demestor/robot_platform/images/robot_back.jpg

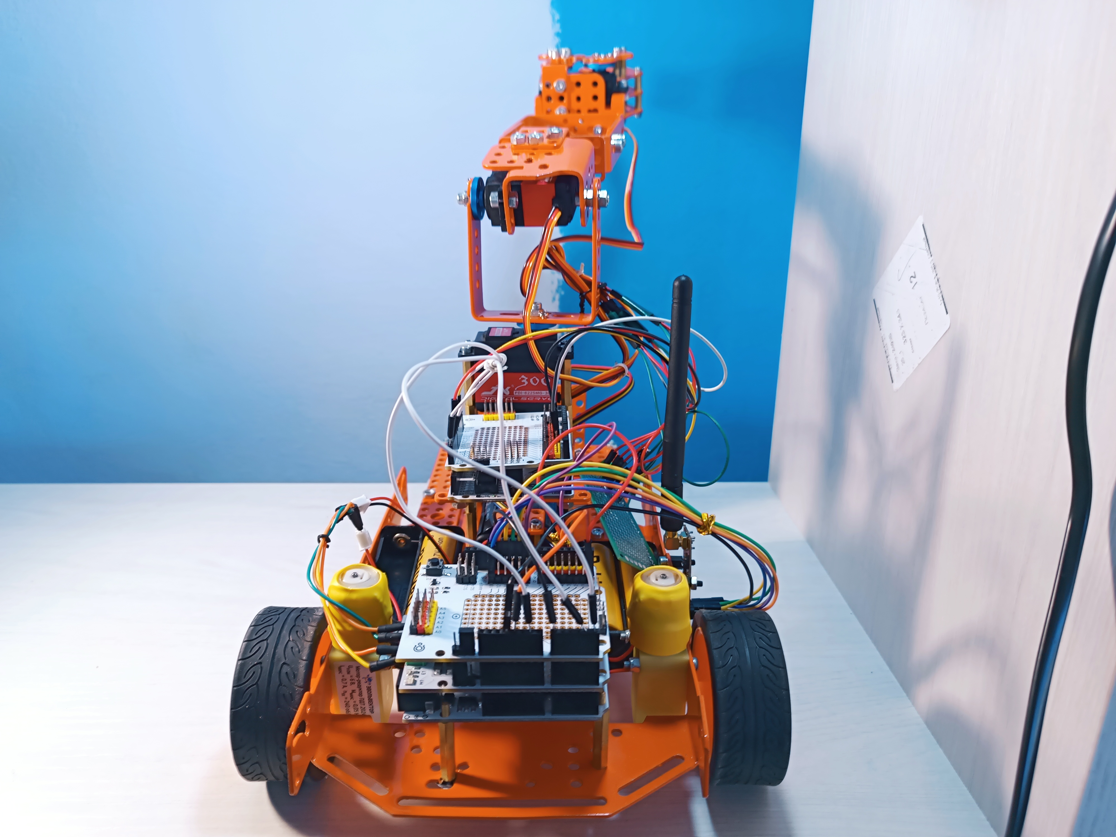
images/robot_back.jpg
