demestor/robot_platform/Сопроводительная записка.docx

Образец оформления титульного листа пояснительной записки

Открытый республиканский конкурс

«Проектный прорыв: моделирование, конструирование и приборостроение»

Направление: Образовательный проект

РАЗРАБОТКА МОБИЛЬНОЙ РОБОПЛАТФОРМЫ С МАНИПУЛЯТОРОМ И СИСТЕМОЙ ДИСТАНЦИОННОГО УПРАВЛЕНИЯ

Автор: Дерябин Игорь Андреевич, Якунин Кирилл Аркадьевич

обучающаяся кружка «Робототехника»

ГБУДО «ЦТТ – «КВАНТОРИУМ»»

Научный руководитель:

Душа Михаил Валерьевич,

педагог дополнительного образования

ГБУДО «ЦТТ – «КВАНТОРИУМ»»

г. Донецк, 2026 г.

# ВВЕДЕНИЕ

В настоящее время на рынке представлено большое количество готовых робототехнических наборов, однако, чаще всего, их функционал ограничен заранее выбранной направленностью, а возможности модификации ограничены. Это не позволяет в полной мере изучить различные направления робототехники детально, получить глубокое понимание основ.

В условиях активного развития инженерного образования в Донецкой Народной Республике существует потребность в открытых, масштабируемых и бюджетных учебных платформах, которые позволят детально изучить основные робототехнические разделы, самостоятельно дорабатывать архитектуру устройства и модифицировать поведение программным кодом.

Цель работы: разработать мобильную робоплатформу с открытым исходным кодом, широкими способами модификации, реализующую возможность изучения основных разделов робототехники: электротехники, программирования, задач кинематики, способов передачи информации.

# 1. РАЗРАБОТКА ПРОЕКТА

Одним из самых увлекательных направлений современного технического творчества является разработка мобильных робоплатформ с манипуляторами. Такие устройства позволяют одновременно изучать механику, электронику, программирование микроконтроллеров, беспроводную связь и системы автоматического управления, репрезентируя процесс промышленного производства или научно-исследовательской разработки. Робоплатформы используются в образовании, на соревнованиях, в поисково-спасательных работах и даже в простых автоматизированных задачах. В настоящее время на рынке и онлайн магазинах представлено большое количество готовых наборов по сборке подобных платформ. Для определения особенностей и характеристик разрабатываемого проекта, был проведен анализ доступной информации и существующих аналогов.

## 1.1 Обзор аналогов

Представленные на рынке робототехнические платформы, программируемые при помощи микроконтроллеров, можно разделить на три основных типа конструкций.

Стационарные манипуляторы. Представляют собой неподвижную платформу со средствами управления и несколькими сервоприводами, установленных в характерный для манипуляторов корпус. Решения позволяют изучить кинематику манипуляторов, изучить ручное и автоматическое управление сервоприводами для решения различных задач, однако ограниченная мобильность и, зачастую, отсутствие возможности доработки платформы ограничивают перечень изучаемых направлений в робототехнике

Мобильные платформы без манипуляторов. Оснащенные драйверами управления и несколькими двигателями в корпусе, данные решения позволяют изучить больший перечень типичных робототехнических задач и направлений, таких перемещение в пространстве, навигация, изменение поведения основываясь на данных с датчиков. Однако отсутствие подготовленной архитектуры не позволяет добавить манипулятор, что не позволяет в полной мере изучить кинематику в робототехнике

Мобильные платформы с манипуляторами. Решения, дающее наиболее близкое понимание основных робототехнических задач. Поскольку разрабатываемый проект ориентируется на данный тип конструкции, был проведен анализ наиболее близких аналогов. Результат анализа приведен в Таблице 1.1.

Таблица 1.1 – сравнительный анализ аналогов проекта

Свойство | Робототехнический набор
| Keystudio 4DOF Mechanical Robot Arm Car | Xiao-r TH Robot Car | РОББО Робоплатформа
Тип управления | Джойстик, приложение через Bluetooth | Приложение через Wi-Fi | Приложение через Bluetooth
Манипулятор | 3 степени свободы | 4 степени свободы | Простой захват
Архитектура | Плата контроллер, плата расширения | Плата контроллер, плата расширения | Модульная
Режимы работы | Ручной, автономный, на основе датчиков | Ручной, автономный, на основе датчиков и камеры | Ручной, автономный, на основе датчиков
Дальность связи | 5–10 м | 30-50 м | до 10 м
Основные недостатки для обучения | Короткая дальность, закрытые примеры кода, ограниченные возможности модификации | Сложная конструкция, ограниченные возможности модификации | Нет манипулятора, привязка к фирменному ПО

Анализ показал, что большинство готовых решений имеют общие ограничения:

Ограниченные возможности управления. Наборы оснащены заранее предусмотренными в конструкции датчиками и модулями связи, что не позволяет использовать собственные способы коммуникации с робоплатформой.

Ограниченные возможности модификации. Отсутствие модульной структуры или структура, поддерживающая ограниченный набор компонентов, значительно ограничивают возможности изучения и доработки платформы, снижают функционал.

Использование одного микроконтроллера. Использование одной управляющей платы упрощает конструкцию, однако лишает робоплатформу модульности и расширяемости, а также лишает возможности изучение проводной связи между микроконтроллерами.

Для решения перечисленных проблем было принято решение разработать оригинальную открытую мобильную робоплатформу с манипулятором под управлением двух микроконтроллеров и управлением через радиомодуль при помощи собственного пульта дистанционного управления и автономным режимом на основе информации с датчиков.

## 1.2 Анализ использованных решений

При разработке робоплатформы был принят ряд технических решений, поспособствовавших улучшению модульности, энергопотребления и связи. Основной особенностью является использование двух микроконтроллеров для управления платформой. Основной микроконтроллер отвечает за обработку радиосигнала и сигнала ультразвукового дальномера, управление двигателями постоянного тока. Второй микроконтроллер отвечает за управление сервомоторами манипулятора. Такое разделение позволяет инкапсулировать разные задачи, упрощая понимание работы отдельных подвижных частей платформы; увеличивает число дополнительных подключаемых датчиков и модулей; позволяет изучить основы передачи информации между микроконтроллерами при помощи шины данных.

Помимо разделения управляющей логики, источник питания также был разделен – отдельные аккумуляторы подключены к каждому микроконтроллеру и питают только модули их зоны функционирования. Такое решение позволит улучшить стабильность работы серводвигателей и двигателей постоянного тока, для которых правильная организация питания критична. Также улучшается модульность конструкции – каждая плата может использоваться как автономный модуль с собственной программой. Разделение позволяет экономить электрический заряд аккумуляторов, потребляя заряд только для используемого модуля.

Следующим важным аспектом является использование модуля радиосвязи вместо модуля приема-передачи по протоколу Bluetooth. Преимуществами радиомодуля является высокая дальность работы, низкое энергопотребление и простота интеграции и настройки. Однако, модульная структура робоплатформы позволяет добавить модуль Bluetooth для управление через мобильные устройства или пульты дистанционного управления на основе этого модуля.

## 1.3 Описание конструкции

Робоплатформа представляет собой модульную систему из двух микроконтроллеров, связанных через интерфейс связи I2C, обрабатывающую сигналы управления при помощи радиомодуля приема-передатчика NRF24L01. На рисунке 1.1 представлена блок-схема работы робоплатформы.

Рисунок 1.1 – блок-схема работы робоплатформы

Микроконтроллер пульта дистанционного управления обрабатывает сигналы элементов управления (кнопки, двухосевой джойстик), формирует и отправляет пакет данных, содержащий указания для робоплатформы, при помощи радиомодуля NRF24L01. Второй радиомодуль на платформе принимает пакет, основной микроконтроллер обрабатывает его и запускает двигатели или ультразвуковой дальномер. Если в пакете содержались данные от двухосевого джойстика, основной микроконтроллер передает их на микроконтроллер манипулятора через интерфейс I2C. Второй микроконтроллер обрабатывает поученные данные и меняет положенение серводвигателей.

На Рисунке 1.2 представлена диаграмма подключения для пульта дистанционного управления.

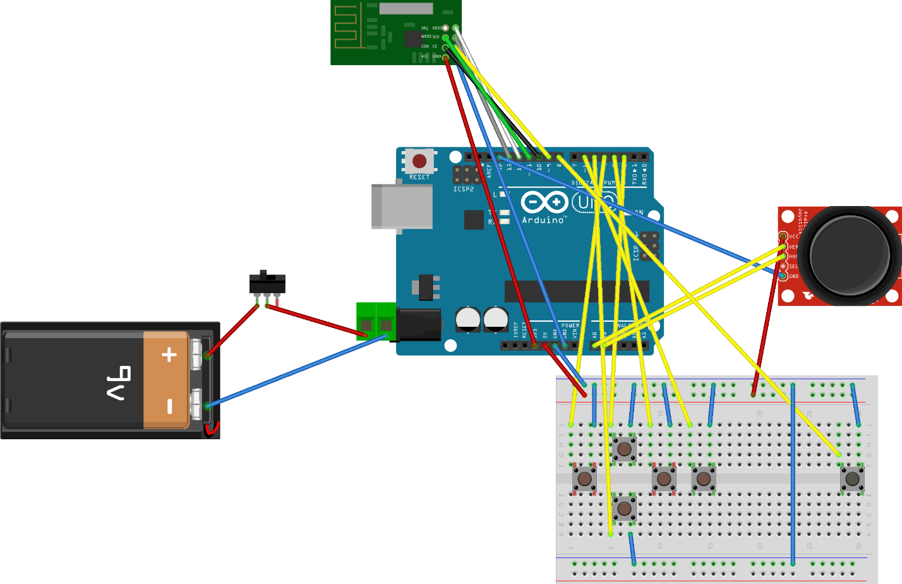
[picture p2: figure]

Рисунок 1.2 - Диаграмма подключения для пульта дистанционного управления.

4 крестообразно расположенные кнопки отвечают за движение робоплатформы. Кнопка справа, подключенная к пину 6, изменяет режим работы – ручное управление или случайное движение на основе ультразвукового дальномера. Крайняя правая кнопка отвечает за закрытие захватного устройства.

Наклон двухосевого джойстика отвечает за изменение двух углов сервоприводов манипулятора. Так как в корпусе пульта модуль джойстика повернут на 90 градусов по часовой стрелке относительно своего основного положения, оси X и Y поменяны местами.

Питание пульта организованно от батареи кроны 9В, подключенную через клеммник с переходом на разъем на разъем jack 2.2 мм. Между положительным полюсом кроны и клеммником припаян ползунковый переключатель, для отключения пульта в неактивном состоянии.

В таблице 1.2 приведен полный перечень электронных компонентов для пульта дистанционного управления.

Таблица 1.2 - перечень электронных компонентов для пульта дистанционного управления

Название | Количество | Характеристики
Плата Iskra Uno | 1 | Микроконтроллер: ATmega328P; Архитектура: AVR (8 бит); Тактовая частота: 16 МГц; Flash-память: 32 КБ; Напряжение логических уровней: 5 В; Входное напряжение через USB: 5 В; Входное напряжение через DC-разъём или пин Vin: 7–12 В; Размеры платы: 69×53 мм
Радиомодуль приема-передатчик NRF24L01 | 1 | Частота: 2,4 ГГц–2,5 ГГц; Рабочее напряжение: не более 3 ~ 3,6 В; Поддержка до шести каналов приема данных; Дальность передачи: до 1000 м
Модуль двухосевого джойстика HW-504 | 1 | Размер: 26×34 мм; Рабочее напряжение: 3,3–5 В
Батарея крона | 1 | Номинальное напряжение: 9 В
Тактовая кнопка | 6
Ползунковый переключатель | 1
Беспаечная макетная плата | 1
Коннектор с клеммником | 1

На рисунке 1.3 представлена диаграмма подключения для робоплатформы и манипулятора

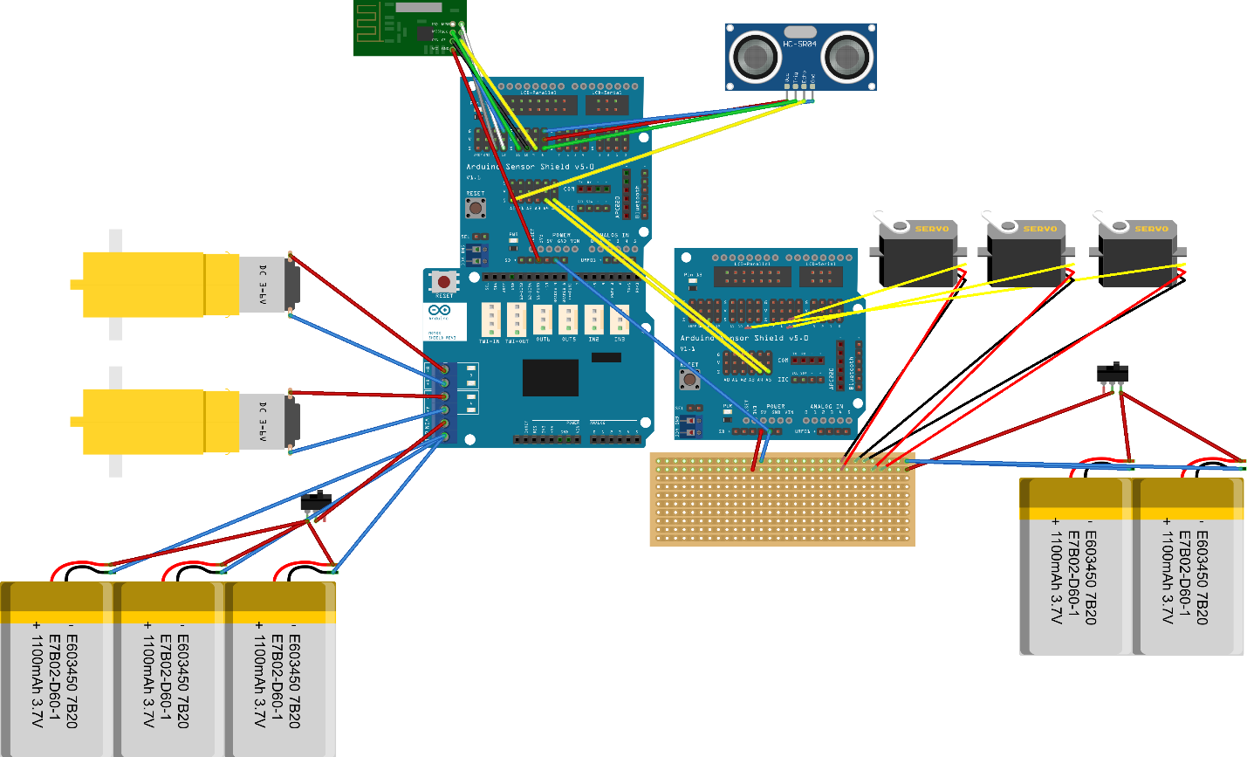
[picture p3: figure]

Рисунок 1.3 - Диаграмма подключения для пульта дистанционного управления.

На схеме обозначены подключения для плат расширения, сами платы подключаются поверх плат с микроконтроллерами.

Управление двигателями осуществляется при помощи платы расширения Motor Shield на базе чипа L298P, моторы подключены к двум каналам платы через клеммники. На третий клеммник платы подключены 3 аккумулятора Li-ion 18650. Между положительными полюсами и клеммником питания припаян ползунковый переключатель, для отключения робоплатформы в неактивном состоянии.

Плата расширения Troyka Shield устанавливается поверх Motor Shield для упрощенного доступа к пинам. К тройным контактам «S-V-G» подключается ультразвуковой дальномер и радиомодуль NRF24L09.

Вторая плата расширения устанавливается поверх второго микроконтроллера, отвечающего за работу сервопривода. Управляющие провода сервомоторов подключены к плате расширения, провода питания выведены и припаяны на перфорированную макетную плату. Между положительными полюсами и клеммником припаян ползунковый переключатель, для отключения манипулятора в неактивном состоянии. Связь между двумя микроконтроллерами по интерфейсу I2C осуществляется через 2 провода А4 и А5.

В таблице 1.3 приведен полный перечень электронных компонентов для робоплатформы и манипулятора.

Таблица 1.3 - перечень электронных компонентов для робоплатформы и манипулятора

Название | Количество | Характеристики
Плата Iskra Uno | 2 | Микроконтроллер: ATmega328P; Архитектура: AVR (8 бит); Тактовая частота: 16 МГц; Flash-память: 32 КБ; Напряжение логических уровней: 5 В; Входное напряжение через USB: 5 В; Входное напряжение через DC-разъём или пин Vin: 7–12 В; Размеры платы: 69×53 мм
Плата расширения Troyka Shield | 2 | Питание подключаемых модулей: 3.3–5 В; Интерфейс I2C: 3 группы контактов
Плата расширения Motor Shield | 1 | Напряжение логической части: 3.3–5 В; Напряжение силовой части в режиме PWR JOIN: 5–12В; Продолжительный ток нагрузки на канал: до 2 А
Радиомодуль приема-передатчик NRF24L01 | 1 | Частота: 2,4 ГГц–2,5 ГГц; Рабочее напряжение: не более 3–3,6 В; Поддержка до шести каналов приема данных; Дальность передачи: до 1000 м
Ультразвуковой дальномер HC-SR04 | 1 | Угол обзора: 15°; Измеряемая дальность: 3–400см; Рабочее напряжение: 5 В
Аккумулятор Rakieta Li-ion 18650 | 5 | Емкость: 12000 мАч; Номинальное напряжение: 3,7 В
Сервомотор Servo PDI-6225MG-300 | 3 | Рабочее напряжение: 4.8–6В; Скорость: 0.21 c/60°; Угол поворота: 300°
Двигатель постоянного тока | 2 | Рабочее напряжение: 3–6В; Продолжительный ток нагрузки: 100-120 мА
Ползунковый переключатель | 2 | -
Перфорированная макетная плата | 1 | -

## 1.4 Технические особенности

Описание робоплатформы

Для корпуса робоплатформы использовались металлические детали из образовательного набора «Эвольвектор». Основой модели выступает робототехническое шасси «ШРЭК», в задней части в местах специальных вырезов крепятся двигатели постоянного тока. В середине шасси установлены два аккумуляторных отсека для питания основного микроконтроллера. В задней части установлены четыре монтажные стойки, на который будет установлен основной микроконтроллер. На правом борту на двух болтах закреплен радиомодуль NRF24L01. Шасси изображено на рисунке 1.4

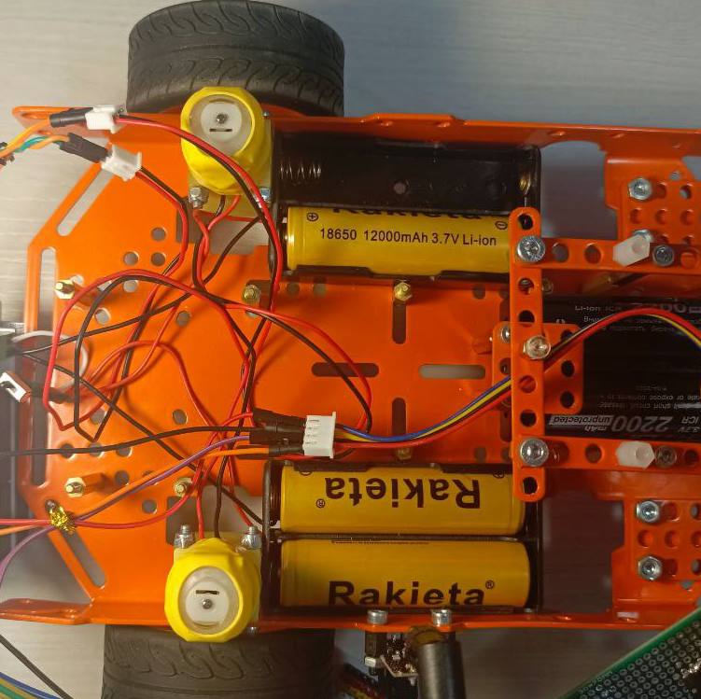
[picture p4: figure]

Рисунок 1.4 – Шасси робоплатформы, вид сверху

Для большей устойчивости перед шасси закреплена платформа квадратной формы, перед ней закреплены два свободновращающихся колеса. В середине платформы на вырезах закреплена прямоугольная пластина, на которой установлен ультразвуковой дальномер HC-SR04. Передняя часть шасси изображена на рисунке 1.5

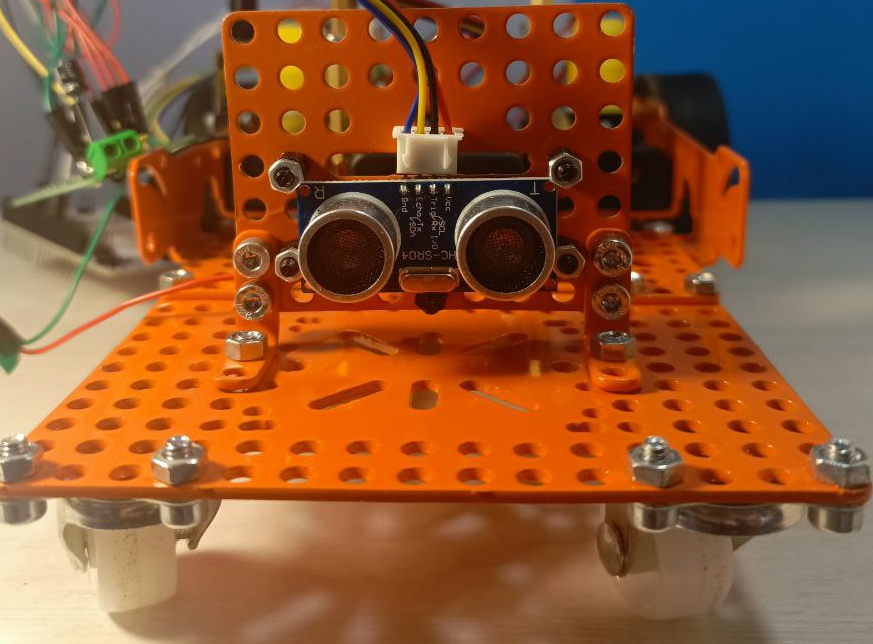
[picture p5: figure]

Рисунок 1.5 – Шасси робоплатформы, вид спереди

Между креплением робошасси «ШРЭК» и квадратной пластиной на четырех стойках установлен микроконтроллер для манипулятора. В свободной нише под микроконтроллером установлен аккумуляторный отсек для питания манипуляторов. От платформы с микроконтроллером на стойках крепится основание манипулятора. Установленный манипулятор изображен на рисунке 1.6.

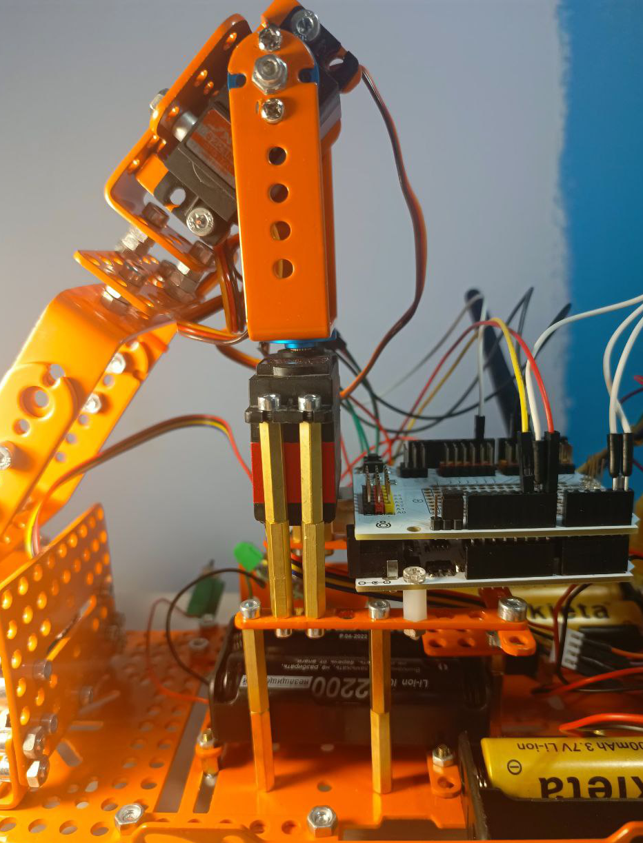
[picture p6: figure]

Рисунок 1.6 – Манипулятор, вид сбоку

На выходном валу сервопривода оси X крепится «П»-образная пластина, между которой прикреплен второй сервопривод оси Y. На выходном валу сервопривода оси Y на двух «П»-образных пластинах закреплено захватное устройство, состоящие из сервопривода и скреплённых при помощи балок изогнутых пластин. Закрытие клешни осуществляется поворотом выходного вала и прикрепленным к нему пластины с зубчатой частью, которая проворачивает противоположную пластину с зубчатой частью, закрепленной на вращающемся шарнире. Захватное устройство изображено на рисунке 1.7.

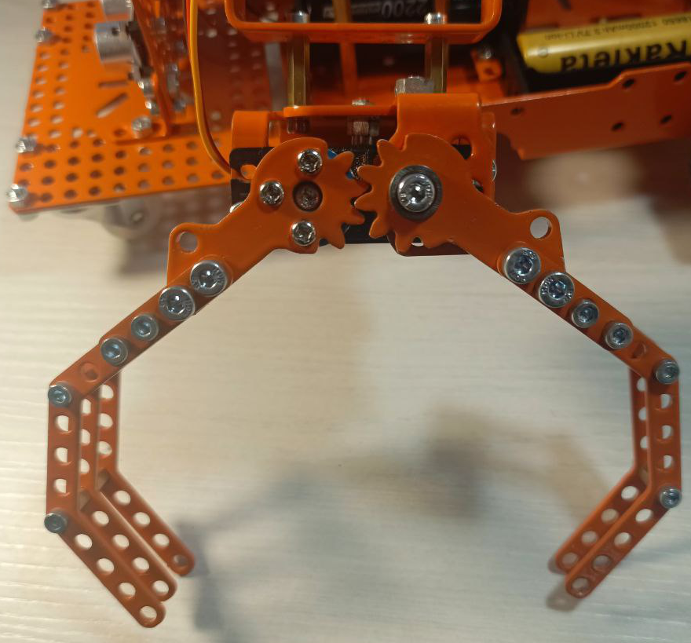
[picture p7: figure]

Рисунок 1.7 – Захватное устройство, вид сверху

Описание пульта дистанционного управления

Пульт дистанционного управления представляет собой напечатанный на 3D принтере корпус в форме видеоигрового контроллера. Исходная модель доступна по ссылке: «https://github.com/demestor/robot_platform/blob/main/pult.obj».

На верхней части корпуса расположен радиомодуль NRF24L01 закрепленный на 2 винта. Соединительные провода для модуля припаяны к В центре установлена макетная плата с кнопками управления движением, сменой режима и закрытия захватного устройств. Справа установлен модуль двухосевого джойстика для управления сервоприводом. Вид сверху пульта управления изображен на рисунке 1.8.

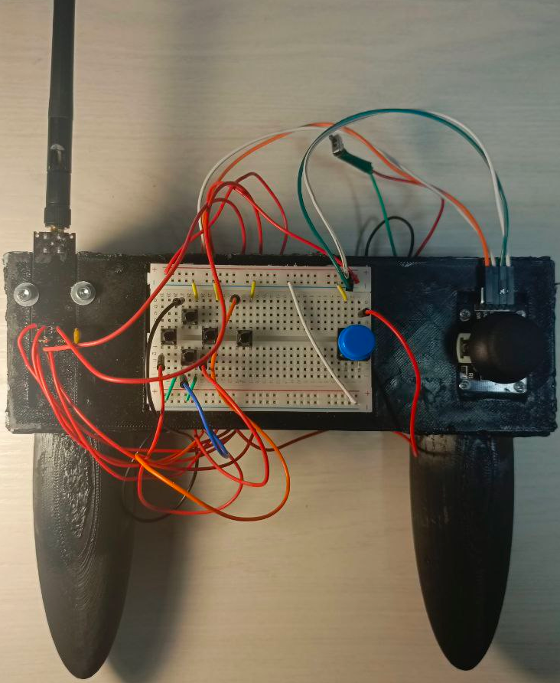
[picture p8: figure]

Рисунок 1.8 – Пульт дистанционного управления, вид сверху

Во внутренней части пульта установлен микроконтроллер и батарея крона, подключенная через клемник-переходник. Соединительные провода проведены от макетной платы и модулей к микроконтроллеру вниз через вырезы. На рисунке 1.9 изображен внешний вид выреза.

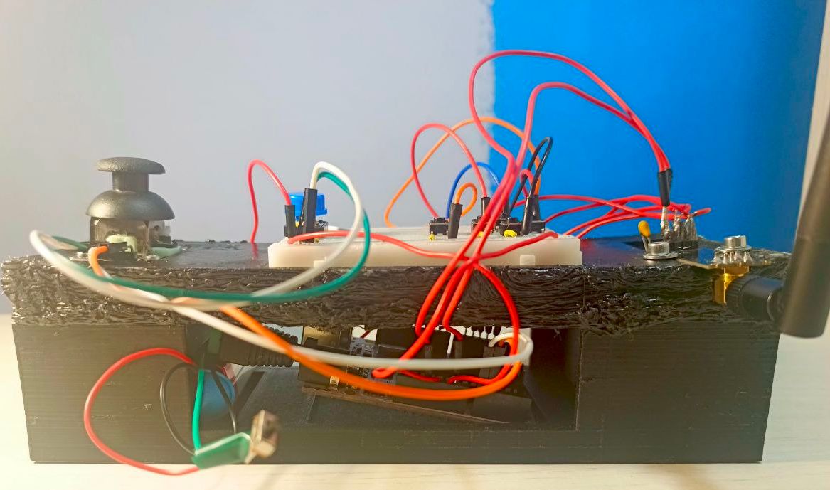
[picture p9: figure]

Рисунок 1.9 – Пульт дистанционного управления, вид спереди

## 1.5 Разработка программного обеспечения

На рисунке 1.10 представлена блоксхема алгоритма работы прошивки для пульта дистанционного управления.

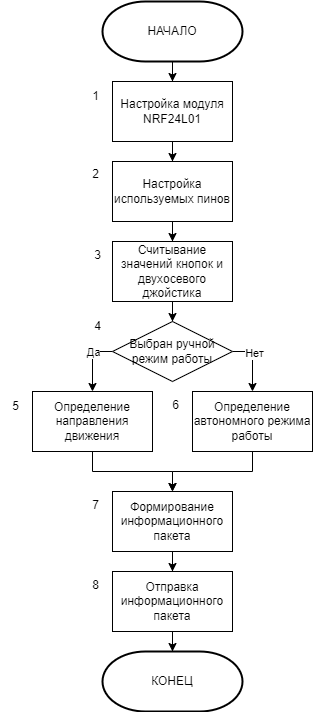
[picture p10: figure]

Рисунок 1.10 – Блок-схема алгоритма работы прошивки пульта дистанционного управления

Работа пульта начинается с настройки радиомодуля NRF24l01: закрепление модуля за пинами, настройка размера передаваемого информационного пакета, настройка «трубы» (логического канала данных) и канала передачи, уровни мощности и скорости передачи данных (блок 1). Далее настраивается режим работы пинов, подключенные к элементам управления (блок 2).

В основном цикле программы считываются значения с элементов управления (блок 3). Если был выбран ручной режим работы, происходит обработка кнопок движения (блок 4). Направление движения сохраняются в переменную func_state, которая принимает значение от 10 до 14: 10 – остановка, 11 – движение вперед, 12 – вправо, 13 – влево, 14 – назад (блок 5). Если выбран режим работы на основе датчиков – обработка кнопок движения прекращается и в переменную записывается значение 15, означающее работу в автономном режиме (блок 6). При формировании пакета (блок 7) закрытие и открытие захватного устройства определяется значением переменной send 1 и 0 соответственно. Значения углов наклона двухосевого джойстика преобразуются в значения от 0 до 255 и сохраняются в переменные X_state для оси X и Y_state для оси Y.

В конце все полученные данные сохраняются в массив transmit_data и отправляются на робоплатформу (блок 8).

На рисунке 1.11 представлена блоксхема алгоритма работы прошивки для робоплатформы.

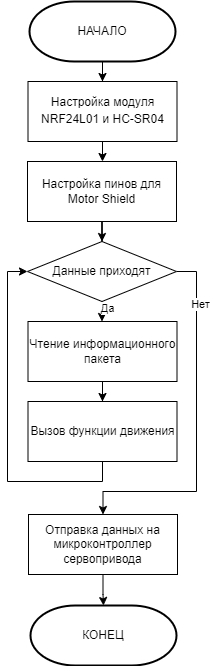
[picture p11: figure]

Рисунок 1.11 – Блок-схема алгоритма работы прошивки робоплатформы

Прошивка робоплатформы начинается с настройки радиомодуля NRF24l01: закрепление модуля за пинами, настройка размера передаваемого информационного пакета, настройка «трубы» (логического канала данных) и канала передачи, соответствующих «трубе» и каналу на пульте управления, уровни мощности и скорости передачи данных. После настраивается ультразвуковой дальномер HC-SR04 – закрепление пинов за датчиком, установка дальности работы. Далее настраивается режим работы пинов для драйвера двигателей Motor Shield.

В основной цикле программы открывается цикл приема информационного пакета. Пока пакеты отправляются, происходит обработка полученных значений: первый элемент массива соответствует направлению движения робоплатформы, остановке или смене режима движения. В режиме работы от датчиков вызывается функция, алгоритм которой представлен на рисунке 1.12.

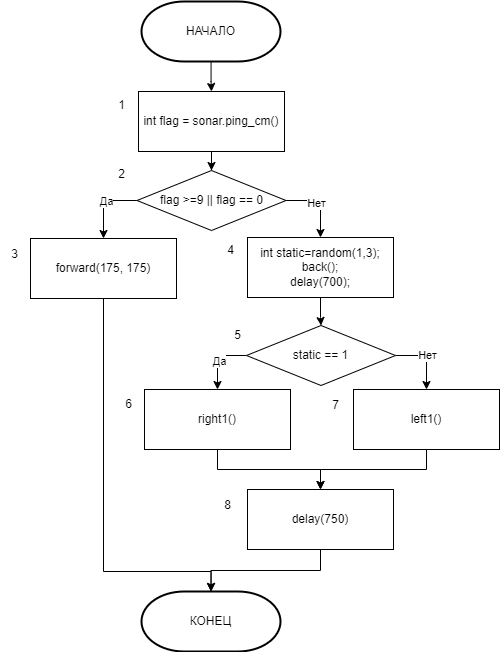
[picture p12: figure]

Рисунок 1.12 – Алгоритм автономного режима работы

Алгоритм начинается со считывания расстояния до препятствия в сантиметрах (блок 1). Если расстояние больше или равно девяти сантиметрам или расстояние равно 0, что означает, что ультразвуковая волна прошла расстояние больше заданного диапазона работы датчика или препятствия нет (блок 2), для робоплатформы включается команда движения вперед со значением скорости 175 для каждого двигателя (блок 3). Иначе в переменную static сохраняется случайное число, 1 или 2, робоплатформе подается команда движения назад в течении 700 миллисекунд (блок 4). Если сохраненное число равняется 1 (блок 5) робоплатформа движется вправо (блок 6), иначе движется влево (блок 7) в течении 750 миллисекунд. Несмотря на простую реализацию алгоритма, он позволит робоплатформе в конечном итоге избежать въезда в препятствие и найти обходной путь.

После обработки полученных значений все данные массива передаются по интерфейсу I2C на микроконтроллер управления манипулятором, обозначенный адресом 1.

На рисунке 1.13 представлен алгоритм работы прошивки для сервопривода.

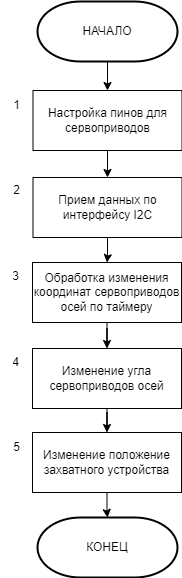
[picture p13: figure]

Рисунок 1.13 – Блок-схема алгоритма работы прошивки сервопривода

Работа алгоритма начинается с настройки подключенных к сервоприводам пинов, при помощи библиотеки ServoSmooth устанавливается скорость движения, режим плавного движения и исходного положения сервоприводов, сохраненных в переменных real_x и real_y (блок 1). Далее, поскольку микроконтроллер сервопривода в иерархии I2C интерфейса является ведомым, ему устанавливается адрес 1, после чего при каждом приеме запускается функция обработки полученных от ведущего устройства данных (блок 2).

В основном цикле программы в блоке 3 обработка изменений угла сервоприводов происходит каждые 10 миллисекунд и при условии, что робоплатформа неподвижна. Это позволяет уменьшить влияние электрического шума на положение сервоприводов и сделать работу манипулятора стабильнее. Если полученные значения наклона осей джойстика отличаются от значений в положении по умолчанию, они переводятся в диапазон от -10 до 10, после чего прибавляются к переменной real_x для оси X и real_y для переменной y, после чего измененное значение передается сервоприводам. Такая обработка позволят незначительными движениями осей джойстика регулировать положение сервоприводов, не возвращаясь к исходному положению манипулятора при отсутствии наклона осей джойстика.

Далее при помощи метода tick устанавливается новое значение для осевых сервоприводов (блок 4) и захватного устройства (блок 5).

# 2. ТЕСТИРОВАНИЕ И РЕЗУЛЬТАТЫ

В результате работы над проектом была разработана мобильная робоплатформа с манипулятором, дистанционным управлением и модульной логикой управления.

## 2.1 Тестирование.

В ходе тестирования были проведены теоретические и практические расчеты. Основной метрикой тестирования является время автономной работы. Расчет проводился отдельно для основного микроконтроллера и микроконтроллера сервопривод.

Время автономной работы рассчитывается по формуле:

T=C×0,85/I

где:

C – ёмкость батареи, мАч

I – средний ток потребления

Значение 0,85 означает коэффициент полезного использования ёмкости аккумулятора, введенный для того, чтобы не допустить глубокой разрядки аккумулятора.

Для расчетов использовались следующие значения потребления тока:

Iskra Uno: 40-60 мА

NRF24L01: 13 мА (режим приема)

HC-SR04: 15 мА

PDI-6225MG-300: 3 * 650 = 1950 мА (холостой ход)

ДПТ: 2 * 500 = 1000 мА

Средний потребляемый ток:

Для мобильного шасси: 60 + 13 + 15 + 1000 = 1088 мА

Для манипулятора: 60 + 1950 = 2010 мА

Емкость аккумуляторах блоков:

Для мобильного шасси: 3 * 12 000 = 36 000 мАч

Для манипулятора: 2 * 12 000 = 24 000 мАч

Рассчитанное время работы:

Для мобильного шасси: 36 000*0,85/1088 = 28 часов

Для манипулятора: 24 000*0,85/2010=10 часов

Следующие метрики определены как вспомогательные и рассчитаны на основе данных из технической документации модулей:

Дальность приема сигнала радиомодулем: более 100 м;

Диапазон углов вращения внешнего вала сервопривода оси X: 90°–170°;

Диапазон углов вращения внешнего вала сервопривода оси Y: 30°–150°;

Максимальная дальность измерения ультразвукового дальномера: 100 см.

В ходе тестирования готового проекта были проведены тесты движения без нагрузки на ровной поверхности, движение манипулятора без нагрузки, захват нетяжелых объектов захватным устройством. Робоплатформа продемонстировала устойчивое движение во всех направлениях, плавное движение манипулятора, захватное устройство стабильно удерживает объект.

## 2.2 Результаты

В ходе выполнения проекта были достигнуты следующие цели:

1. Платформа разработана по методологии открытого исходного кода, не привязана к фирменному ПО, программа платформы легко модифицируется. Все материалы, касающиеся проекта, выложены в свободный доступ и доступны по ссылке: https://github.com/demestor/robot_platform.
2. Функционал робоплатформы позволяет полноценно изучить основные робототехнические направления: конструирование электронных схем, программирование, средства связи, динамика и кинематика.
3. Робоплатформа имеет модульную структуру, сконструирована из доступных компонентов без встроенных изменений. Платформа имеет обширные возможности модификации, изменяющие или улучшающие существующий функционал.

# ЗАКЛЮЧЕНИЕ

В результате выполнения проекта была достигнута поставленная цель: разработан и изготовлен действующий образец мобильной робоплатформы с манипулятором и оригинальной системой дистанционного управления на базе двух плат Iskra Uno, модулей nRF24L01 и сервоприводов PDI-6225MG-300.

Помимо технического результата, работа над проектом позволила получить важные навыки: понимание принципов построения комплексных робототехнических систем, работу с беспроводной связью, шиной I²C, программированием микроконтроллеров и сервоприводами. Также были развиты навыки командной работы, творческого решения возникающих проблем и оформления технической документации.

Проект показал реальную возможность применения современных технологий в образовательных целях и открыл перспективы для дальнейшего совершенствования робота (добавление камеры, голосового управления, датчиков линии).

# СПИСОК ЛИТЕРАТУРЫ

1. Блум Дж. Изучаем Arduino : инструменты и методы технического волшебства : пер. с англ. – СПб. : БХВ-Петербург, 2015. – 336 с.
2. Момот М. В. Мобильные роботы на базе Arduino. – 3-е изд. – СПб. : БХВ-Петербург, 2023. – 336 с.
3. ATmega328P. 8-bit AVR Microcontroller with 32K Bytes In-System Programmable Flash : Datasheet [Электронный ресурс] / Microchip Technology Inc. – URL: https://ww1.microchip.com/downloads/en/DeviceDoc/Atmel-7810-Automotive-Microcontrollers-ATmega328P_Datasheet.pdf (дата обращения: 05.03.2026).
4. nRF24L01+ Single Chip 2.4 GHz Transceiver : Product Specification [Электронный ресурс] / Nordic Semiconductor. – URL: https://www.nordicsemi.com/-/media/Software-and-other-downloads/Product-Specifications/nRF24L01_Product_Specification_v1_0.pdf (дата обращения: 05.03.2026).
5. Искра Uno : документация [Электронный ресурс] // Амперка : вики. – URL: https://wiki.amperka.ru/products:iskra-uno (дата обращения: 05.03.2026).
6. Уроки Arduino [Электронный ресурс] / Алекс Гайвер. – URL: https://alexgyver.ru/lessons/ (дата обращения: 05.03.2026).
7. Arduino Documentation [Электронный ресурс]. – URL: https://docs.arduino.cc (дата обращения: 05.03.2026).
8. Evolvector : образовательный портал [Электронный ресурс]. – URL: https://evolvector.ru (дата обращения: 05.03.2026).
