demestor/robot_platform/images/mashine_algoritm.drawio.png

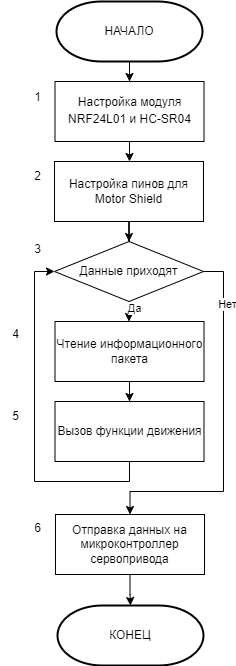
images/mashine_algoritm.drawio.png
