demestor/robot_platform/images/pult_scheme_МП.png

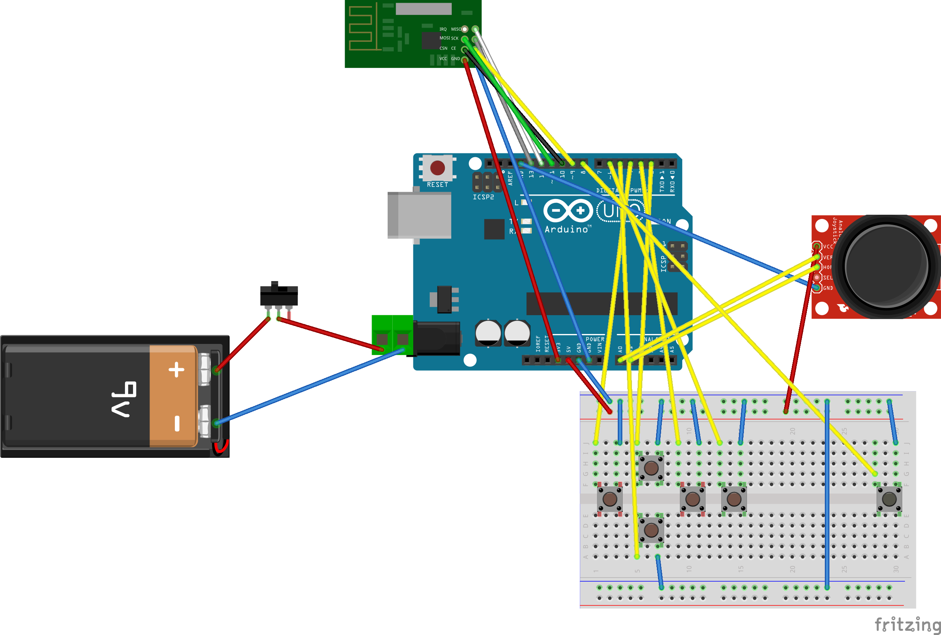
images/pult_scheme_МП.png
