demestor/robot_platform/pult.obj

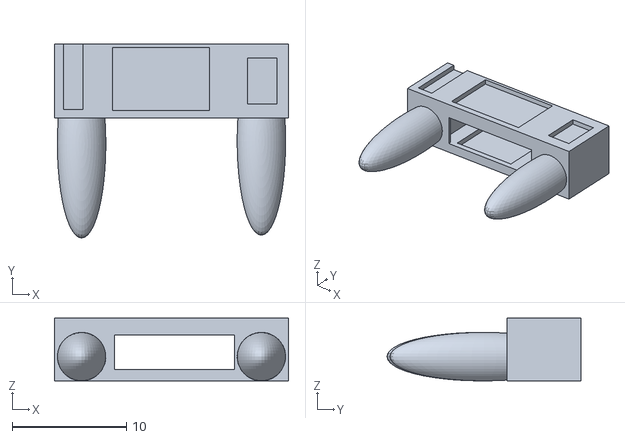
[picture p16: CAD file, 2026-03-04]
pult.obj
20.5 x 17.0 x 5.50
