demestor/robot_platform/(list of files, drawings)

Other design files:
breadboard_schmeses/pult_scheme.fzz
breadboard_schmeses/robot_scheme.fzz
