demestor/robot_platform/(commit log)

2026-03-02 add skatches, schemes, images, statring explanatory note
    [pult_scheme.fzz, robot_scheme.fzz]
2026-03-04 add .obj model, update doc
    [pult.obj, robot_scheme.fzz]
